Darkstar77/Voron/README.md

# Voron
---
Just a place for me to drop various files related to my Voron 3D Printers.
