Darkstar77/Voron/2.4/stls/V2.4857.stl

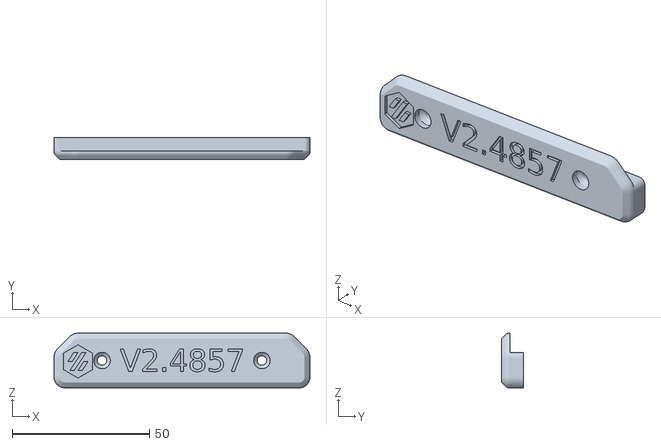
[picture p3: CAD file, 2023-02-17]
2.4/stls/V2.4857.stl
93.2 x 8.00 x 20.0
