Darkstar77/Voron/Switchwire/stls/VS.418.stl

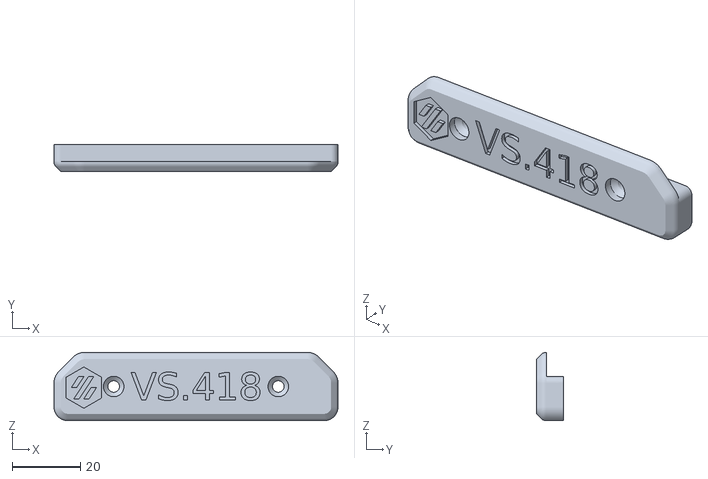
[picture p4: CAD file, 2023-02-17]
Switchwire/stls/VS.418.stl
83.2 x 8.00 x 20.0
