Darkstar77/Voron/TAP/stls/TAP_Centre_R6.2_LDORail.stl

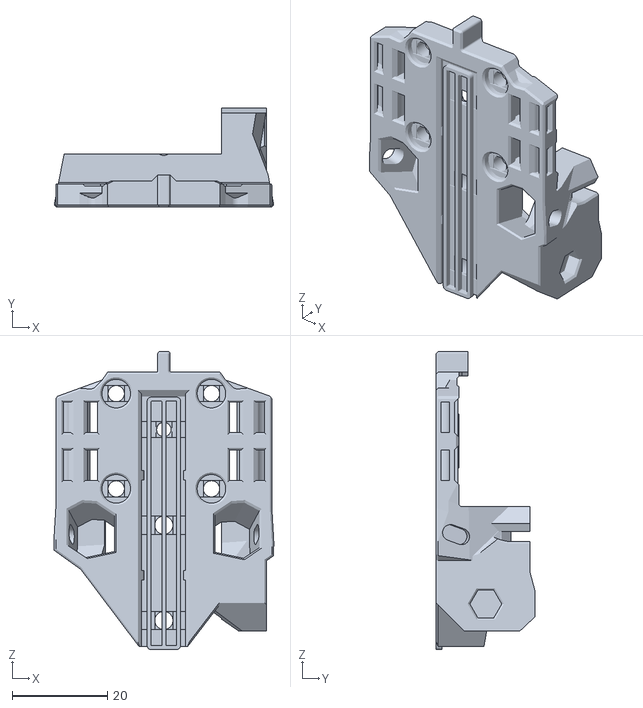
[picture p5: CAD file, 2023-02-26]
TAP/stls/TAP_Centre_R6.2_LDORail.stl
46.1 x 20.7 x 62.6
