Darkstar77/Voron/Switchwire/stls/VS.418-NoLogo.stl

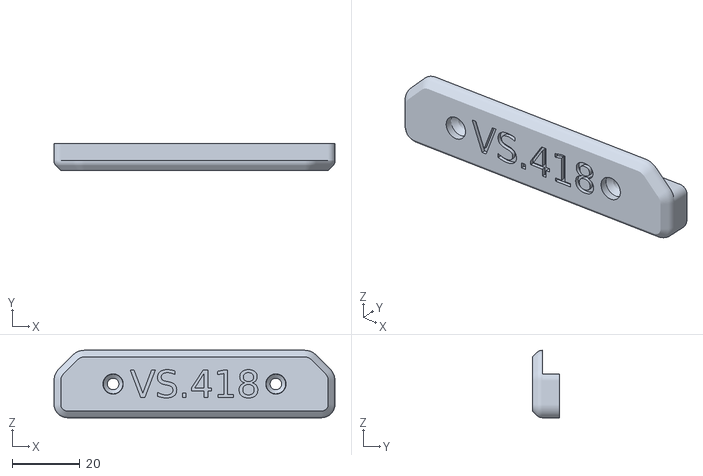
[picture p7: CAD file, 2023-02-17]
Switchwire/stls/VS.418-NoLogo.stl
83.2 x 8.00 x 20.0
