Darkstar77/Voron/TAP/stls/TAP-LDO_MGN12H_Spacer.stl

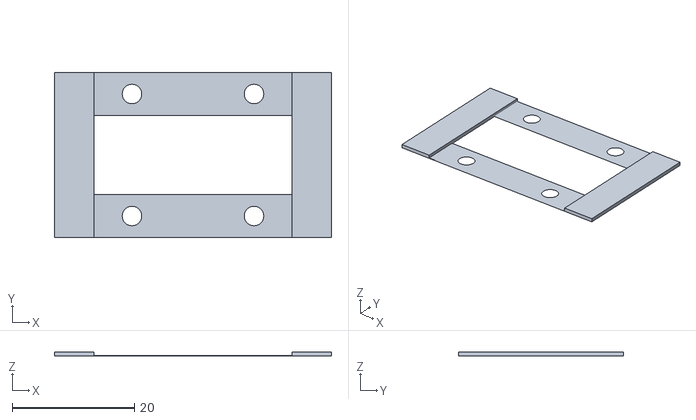
[picture p8: CAD file, 2023-02-17]
TAP/stls/TAP-LDO_MGN12H_Spacer.stl
45.4 x 27.0 x 0.7
