Darkstar77/Voron/(list of files, cad)

Other CAD files:
TAP/stls/TAP_Centre_R6_LDORail.stl
