Darkstar77/Voron/(commit log)

2023-02-25 Added new TAP parts
    [TAP-LDO_MGN12H_Spacer.stl, TAP_Centre_R6_LDORail.stl]
2023-02-25 Revision to TAP Centre
    [TAP_Centre_R6_LDORail.stl]
2023-02-26 Updates to TAP section.
    [TAP_Centre_R6.2_LDORail.stl]
